Romultra/Think-Water/Report/IP First claims.pdf

## Claims :

1. Designing a hydration tracking system based on personalized information from the user
a. Use of sex, weight, age to put in a regression model to create a highly personalized software to calculate the daily water consumption.
2. The device works using 2 separate physical units with distinct functionalities.
a. The first one acting as a measurement unit.
b. The second one, that acts as a central processing unit.
3. In addition to claim 2, The product will use a combination of 2 different complementary stimuli.
a. An audio stimuli will be emitted from the base station
b. A visual stimuli will be emitted from the measurement device.
4. Following claim 2.a, the measurement unit is attachable to a glass or any surface using an attachment mechanism (pneumatic, magnetic, or else). Allowing for a transportable measurement unit ensuring simplicity of use.
5. Additionally, from claim 2.b, the base station is computing all the information and goals for the user and will be in charge of displaying it using a user interface such as a screen. It also acts as a storage unit.
a. The station is also equipped with a dynamic and tunable interface for the user. It can display many information such as the water consumption over different periods of time, where the user is compared to its daily goal, additional information such as temperature, humidity, time and date
6. Following claim 5, remote access to the data stored in the base can be accessed either by healthcare professionals, either by family or relatives to check on the water consumption from the user or for personal use to access it when far away from home.
