Romultra/Think-Water/Report/logos/Table of stakeholders.pdf

Stakeholders | Interests/Needs
Eldery people | Maintain proper hydration to support health and prevent dehydration-related issues
Use simple and reliable technology that helps them monitor water intake effortlessly Clear visual or auditory reminders to drink water
Families | Take care of their elders by ensuring they are properly hydrated
| Remote monitoring of the hydration level of their relatives Affordable and durable device suitable for household use
Hospitals, doctors, nurses at home | Hospitalize people if needed
| Send nurses at home for seniors Hygienic, easy-to-clean, and reusable device
| Meaningful estimation of water intake
EMS | Take care of elderly people
| Prevent any issues, ensure patients maintain adequate hydration Simple device setup and maintenance by staff
Public health actors/ Prevention | Check on elderly people to maintain optimal hydration during heat wave
| Reduce healthcare costs associated with dehydration-related illnesses, especially among elderly populations Promote public health and wellness through better hydration habits
Health care insurance | Reduce medical costs linked to dehydration-related hospitalizations
| Encourage preventive health behaviors among insured individuals
Investors | Association with an innovative and socially impactful product
| Participation in the growing health-tech market
| Return on investment through scalable market adoption
Suppliers | Demand for components or materials used in the device
| Long-term business relationships
Retailers | Expand their product offer with an innovative health technology
| After-sales support and warranty information
EPFL | Provide students with a practical and innovative project to develop skills in Product Design
| Promote research, experimentation, and real-world applications of course material
| Clear project goals, milestones, and deliverables from students
