Romultra/Think-Water/Report/Interview.pdf

Gaëtan Meystre, médecin à l'hôpital cantonal de Rennaz:
1. Êtes-vous renseigné sur les dangers et les conséquences de la déshydratation?
Oui : la déshydratation est notamment responsable de troubles électrolytiques (hypernatrémie) qui peuvent provoquer des troubles de l'état de conscience (confusion, coma, voire mort). L'hypovolémie due à la déshydratation peut également provoquer des affection rénales (insuffisance rénale aiguë) ou des troubles hémodynamiques et cardiaques (hypotension orthostatique, arythmies)
2. Quels sont les causes de déshydratation les plus communes ? (perception de la soif, mobilité réduite, perte d’autonomie, condition climatiques)
Effectivement avec l'âge la perception de la soif est altérée, étant probablement la cause la plus commune. Les troubles neurocognitifs peuvent également augmenter le risque (oubli de boire). La canicule est un exacerbateur au vu des pertes d'eau augmentées dues à la chaleur.
3. Y a-t-il des conditions médicales et des traitements qui améliorent ou empirent la déshydratation ?
Comme condition médicale qui me vient en tête je dirais le diabète (mellitus et insipide) qui part définition est une augmentation des pertes d'eau. Dans les traitements souvent prescrits, il y a les diurétiques utilisés dans le traitement de l'insuffisance cardiaque (chronique et aiguë) dont le but est d'augmenter la production d'urines pour éliminer l'eau accumulée.
4. Qui sont les personnes les plus concernées par la déshydratation?
Les personnes âgées.
5. Quels sont les coûts liés à la déshydratation pour une personne?
Aucune idée
6. Dans quelles mesures êtes-vous exposé aux problèmes de déshydratation? Je suis médecin dans un service de médecine interne, donc beaucoup...
7. Avez-vous une idée du taux d’hospitalisation dû à la déshydratation ?
Il y a pas beaucoup de patient dont le motif d'hospitalisation principal est la déshydratation. La plupart du temps ces patients viennent dans un contexte d'état confusionnel aigu, donc je dirais 2 % des patients hospitalisés ? Par contre beaucoup des patients qui sont hospitalisés pour un autre motif sont déshydratés.
8. Dans quelle mesure voyez vous la déshydratation comme un problème important de santé publique?
C'est un problème important qui touche une grande partie de la population âgée
9. Quelles solutions utilisez-vous déjà pour ce problème et y a t il des points d’amélioration ? J'utilise surtout la prévention, mais je doute qu'il y ait vraiment un impact. Parfois les patients ont des infirmiers à domiciles qui permettent un meilleur contrôle sur ce genre de problèmes, mais on ne les sollicite jamais que dans cet objectif là.
10. Avez vous des idées de solutions pour pallier au problème de la déshydratation ?
Des alarmes qui rappellent quand boire ?

Agnès Tissot :

1. Avez-vous déjà été exposé aux problèmes de déshydratation?

Oui surtout en lien avec deglutition prefere ne pas s’hdrater que de s'étouffer .

2. Quels sont les causes de déshydratation les plus communes ? (perception de la soif, mobilité réduite, perte d’autonomie, condition climatiques)

demence oublie sensation de soif peur de se lever 36000 fois prefere ne pas boire que de setrangler, fatigue

3. Y a-t-il des conditions médicales et des traitements qui améliorent ou empirent la déshydratation ?

deglutination ( épaississenment ou verres adaptés ) diminuer pb de deglute incontinence protection urinaire pour pas courir aux toilettes ou mettre en place une chaise percee

4. Qui sont les personnes les plus concernées par la déshydratation?

personnes agées clairement

5. Quels sont les coûts liés à la déshydratation pour une personne?

aucune idée

7. Avez-vous une idée du taux d’hospitalisation dû à la déshydratation ?

assez important

8. Dans quelle mesure voyez vous la déshydratation comme un problème important de santé publique?

très important consequences graves pour personnes agées

9. Quelles solutions utilisez-vous déjà pour ce problème et y a t il des points d’amélioration ?

dans mes patients oui , ce qui ont un suivi , moins de sequelles ( ex: desorientation liée a la deshydratation)

10. Avez vous des idées de solutions pour pallier au problème de la déshydratation ? des pistes de recherche qu’on pourrait creuser ?

système de memo , jouer sur les habitudes des gens pour que ca devienne une habitude solution facile daccées jouer sur les systemes cognitifs
