Romultra/Think-Water/Report/Capture d’écran 2025-11-23 à 21.23.33.png

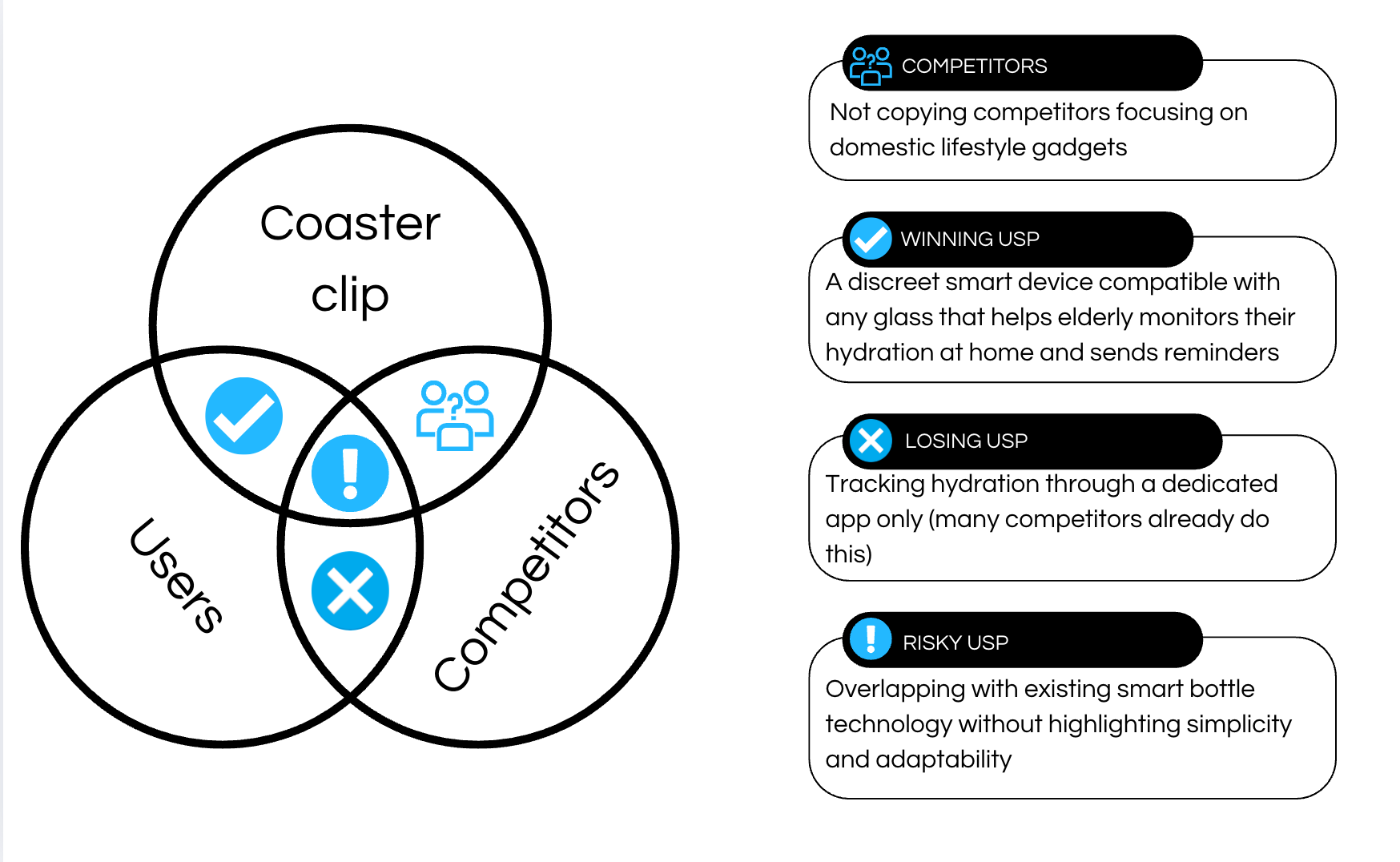
Report/Capture d’écran 2025-11-23 à 21.23.33.png
