Romultra/Think-Water/Report/CONOPS.png

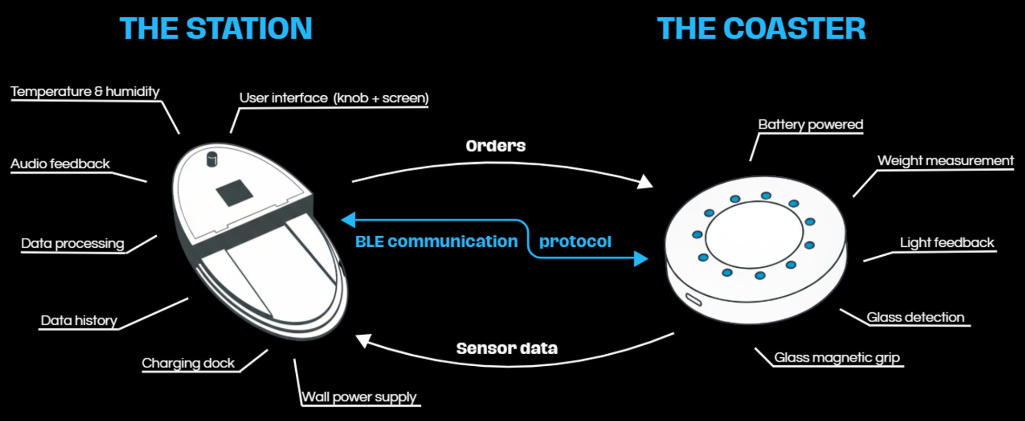
Report/CONOPS.png
