Romultra/Think-Water/Report/Photos/base_station.png

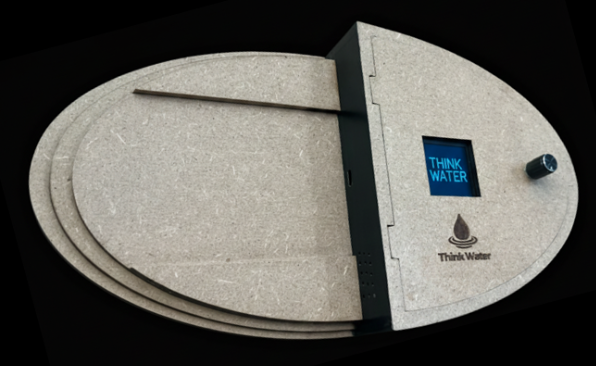
Report/Photos/base_station.png
