Romultra/Think-Water/Report/Photos/coaster.png

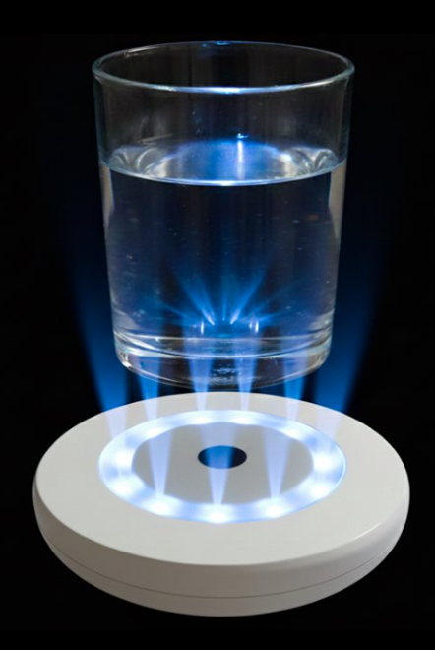
Report/Photos/coaster.png
