Romultra/Think-Water/Report/Photos/ConOps.png

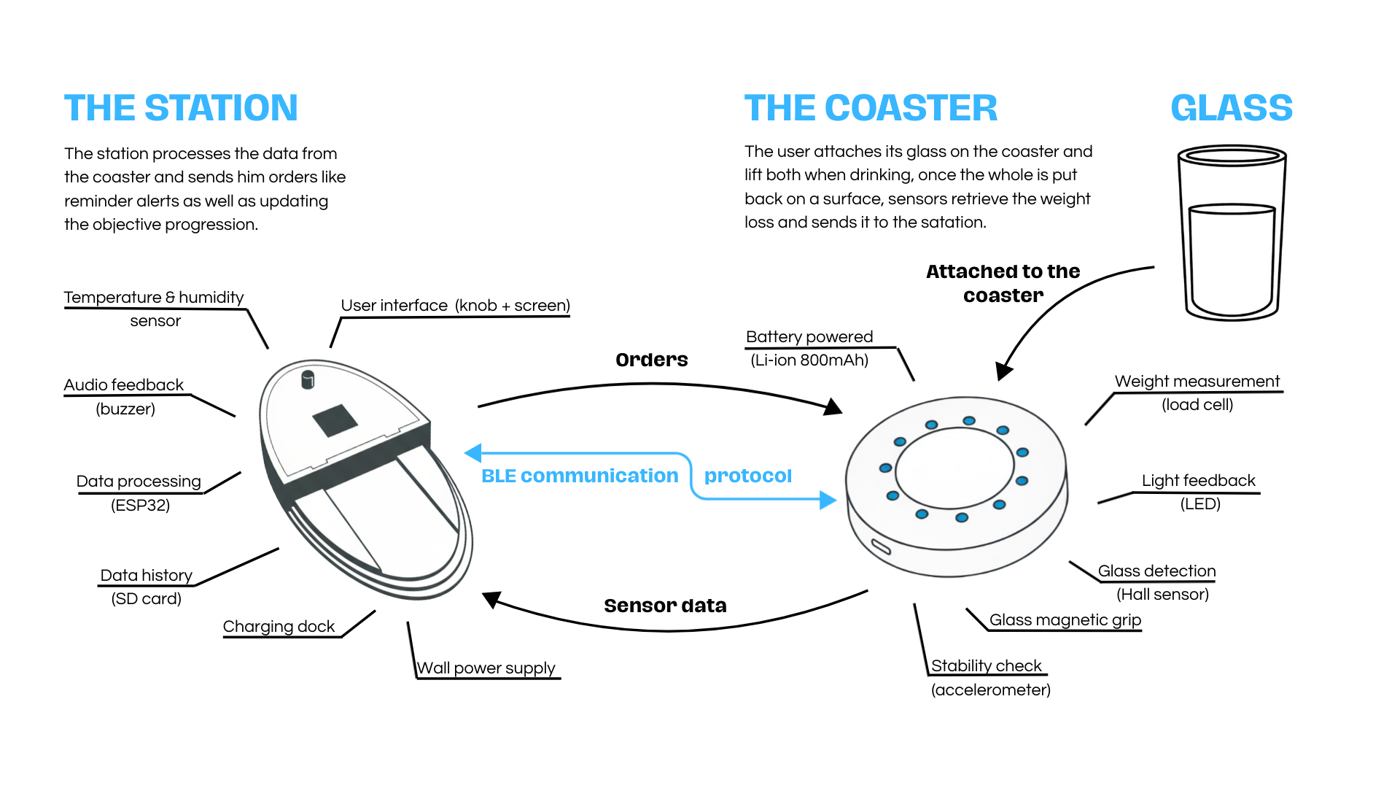
Report/Photos/ConOps.png
