Romultra/Think-Water/Report/Photos/prix.png

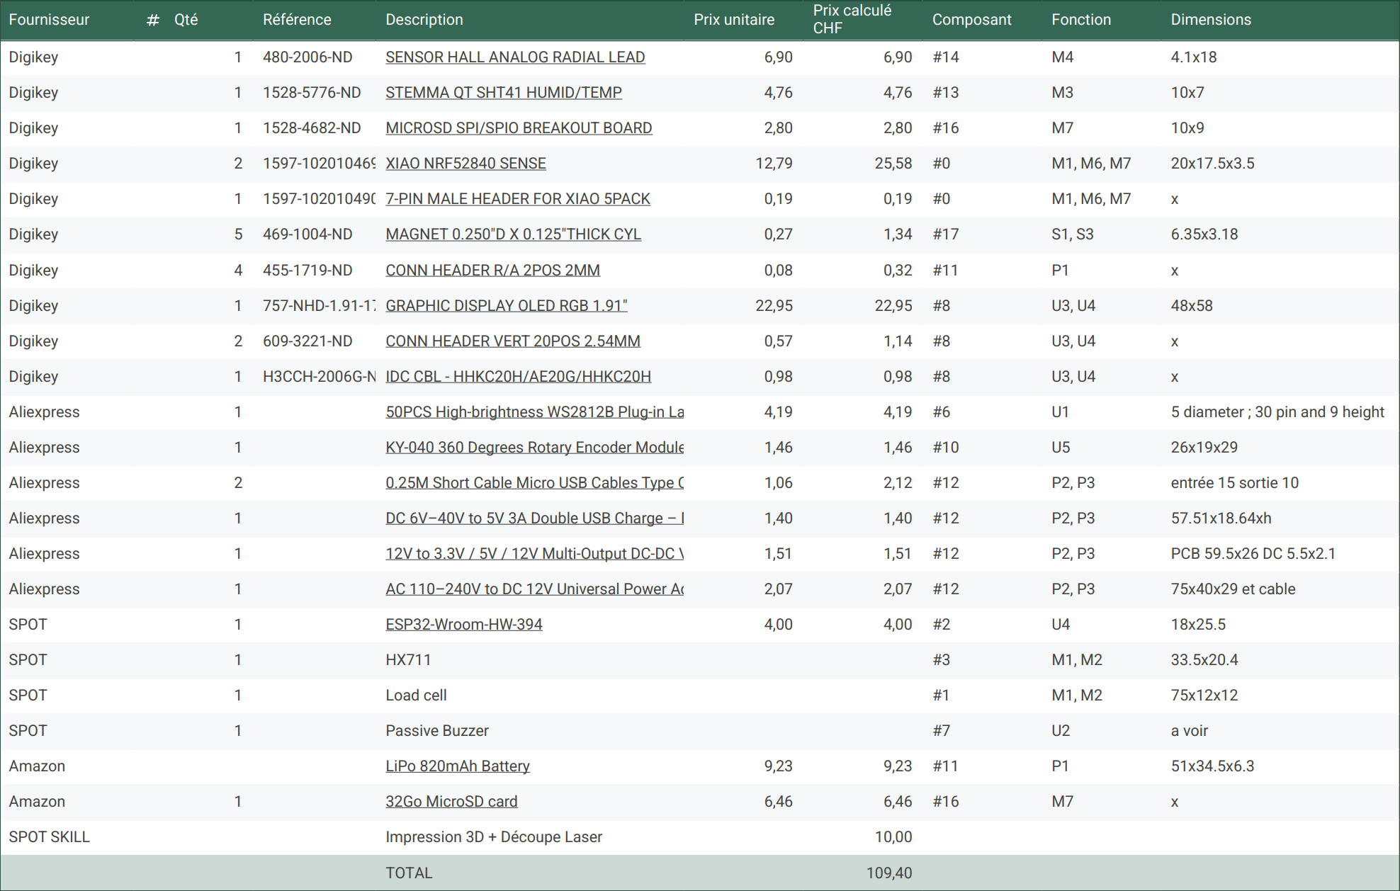
Report/Photos/prix.png
