Romultra/Think-Water/Report/Photos/support_battery.png

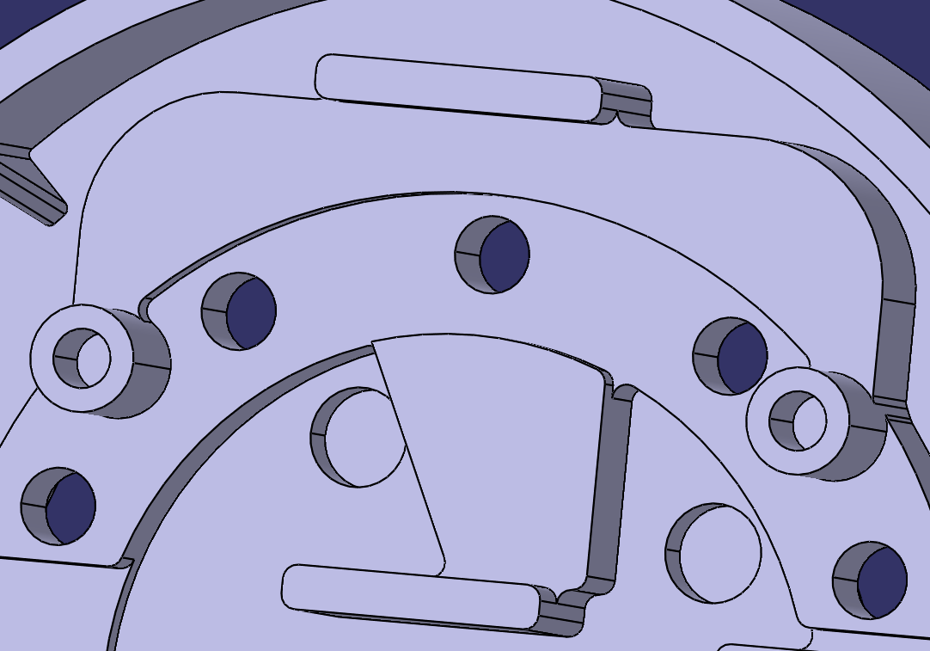
Report/Photos/support_battery.png
