Romultra/Think-Water/Report/Photos/support_loadcell.png

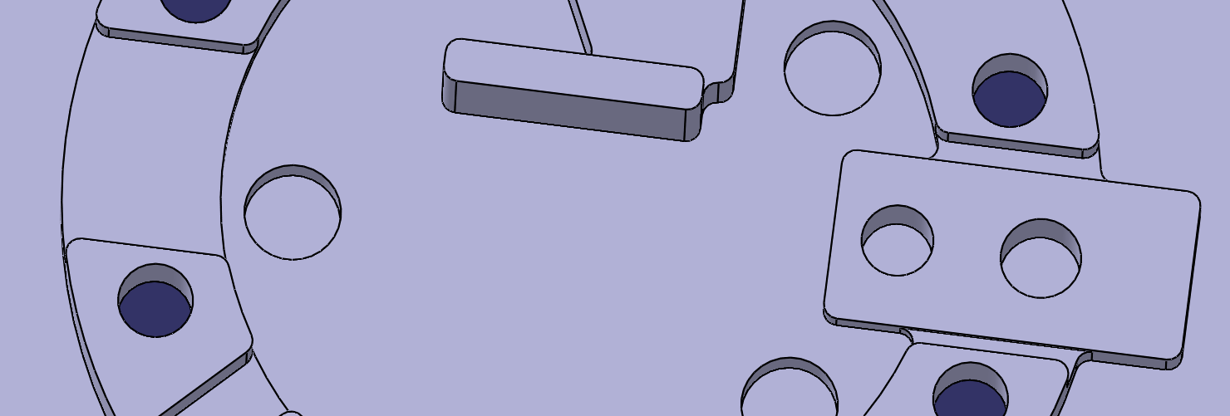
Report/Photos/support_loadcell.png
