Romultra/Think-Water/Report/Photos/support_micro.png

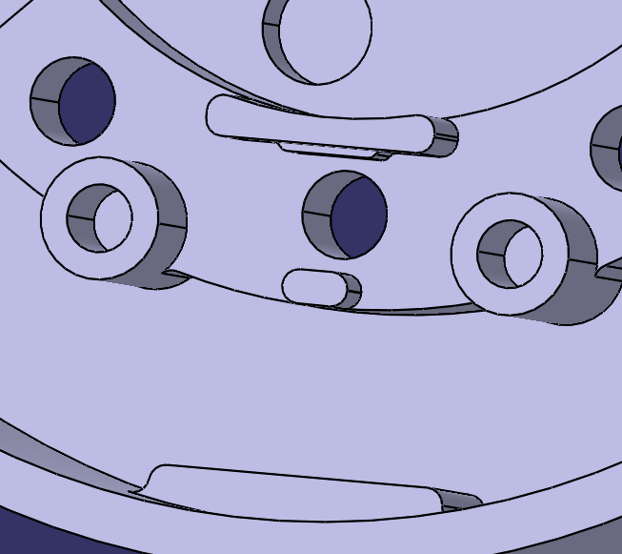
Report/Photos/support_micro.png
