Romultra/Think-Water/Calibration/CALIB.CSV

reference_g | raw_value
0.00 | -57550
100.00 | -94875
50.00 | -76181
20.00 | -64986
10.00 | -61236
0.00 | -57490
5.00 | -59278
4.00 | -58951
2.00 | -58188
1.00 | -57782
0.00 | -57409
150.00 | -113445
170.00 | -120916
200.00 | -132121
80.00 | -87260
70.00 | -83500
170.00 | -120867
160.00 | -117166
210.00 | -135856
100.00 | -94651
0.50 | -57477
0.00 | -57298
