Romultra/Think-Water/Calibration/HALL.CSV

state | min | max | avg
with_glass | 453 | 457 | 454
with_glass | 448 | 459 | 454
no_glass | 471 | 477 | 473
no_glass | 471 | 477 | 473
with_glass | 453 | 458 | 455
with_glass | 447 | 458 | 454
no_glass | 465 | 476 | 473
no_glass | 464 | 478 | 473
with_glass | 453 | 459 | 455
no_glass | 464 | 476 | 473
with_glass | 453 | 459 | 454
with_glass | 454 | 459 | 456
with_glass | 453 | 457 | 454
no_glass | 467 | 476 | 473
