Romultra/Think-Water/Calibration/calibration_plot.png

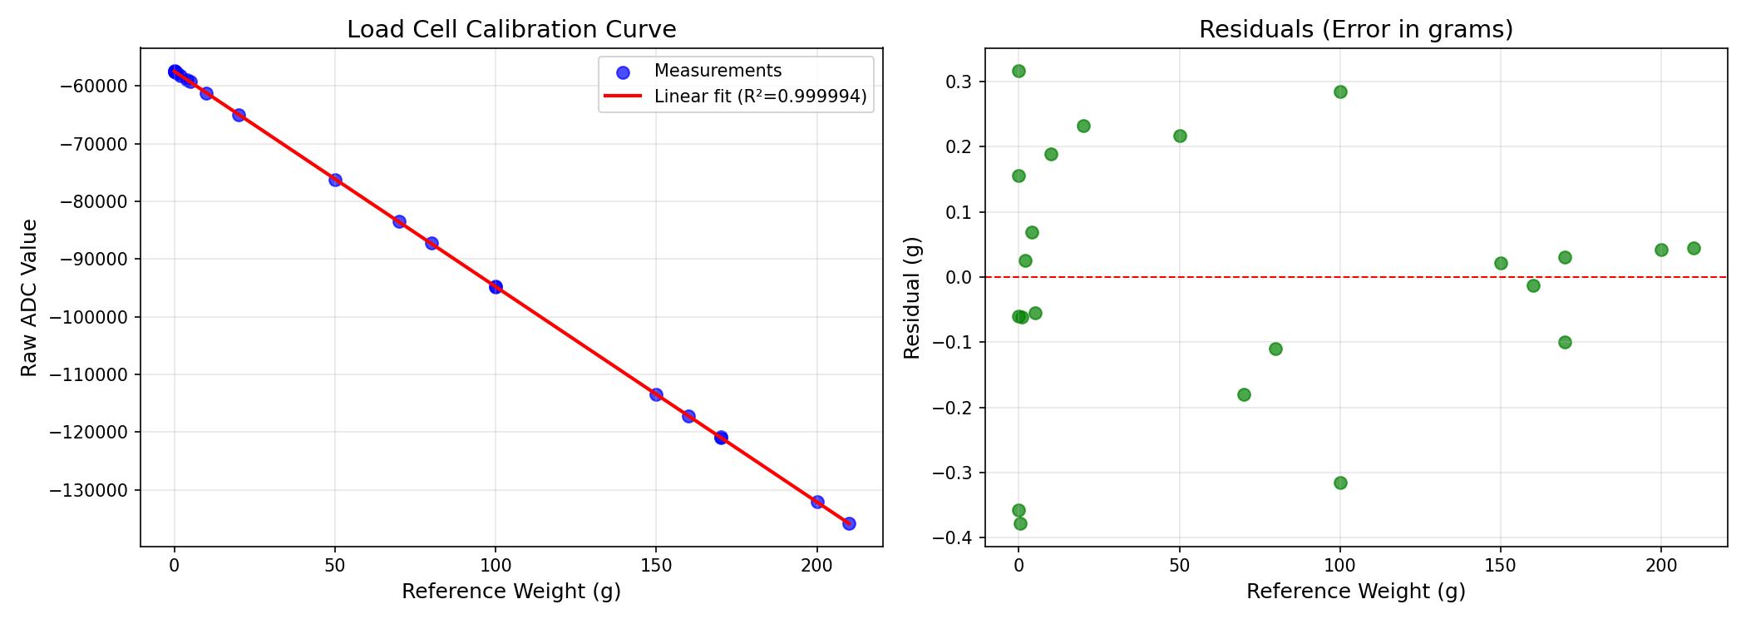
Calibration/calibration_plot.png
