Romultra/Think-Water/Schematics/Base-Station.pdf

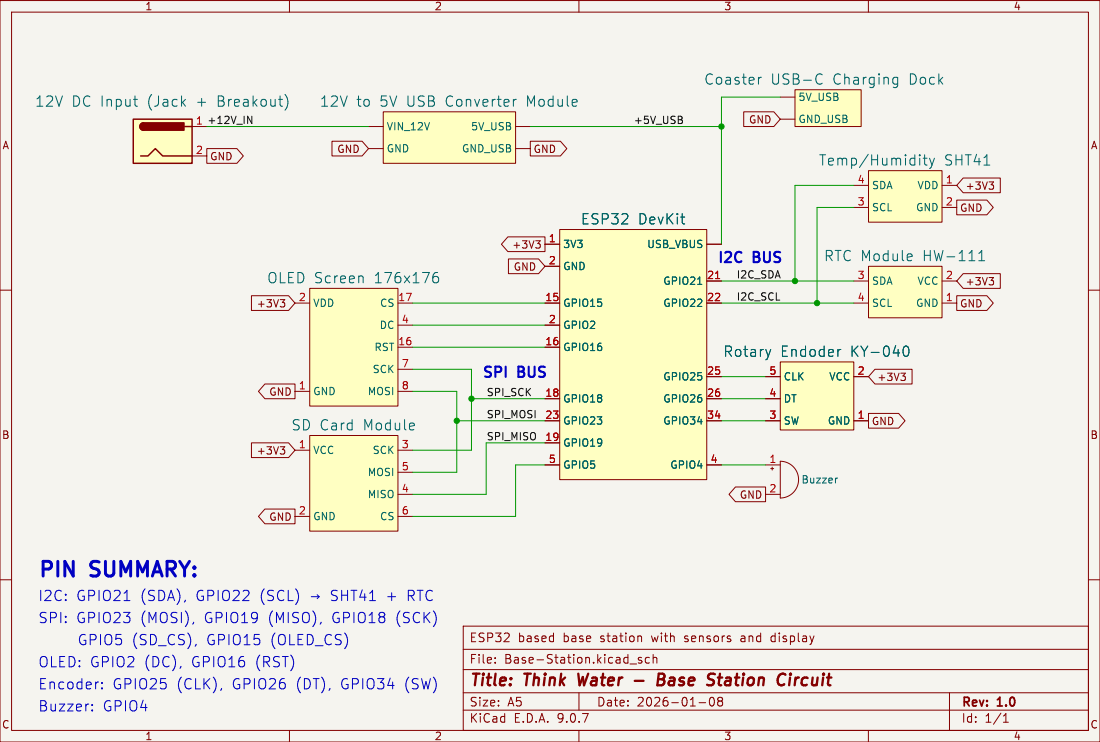
[picture p29: page 1]

PIN SUMMARY:
I2C: GPIO21 (SDA), GPIO22 (SCL) þÿ!’SHT41 + RTC
SPI: GPIO23 (MOSI), GPIO19 (MISO), GPIO18 (SCK)
GPIO5 (SD_CS), GPIO15 (OLED_CS)
OLED: GPIO2 (DC), GPIO16 (RST)
Encoder: GPIO25 (CLK), GPIO26 (DT), GPIO34 (SW)
