Romultra/Think-Water/Schematics/Coaster.pdf

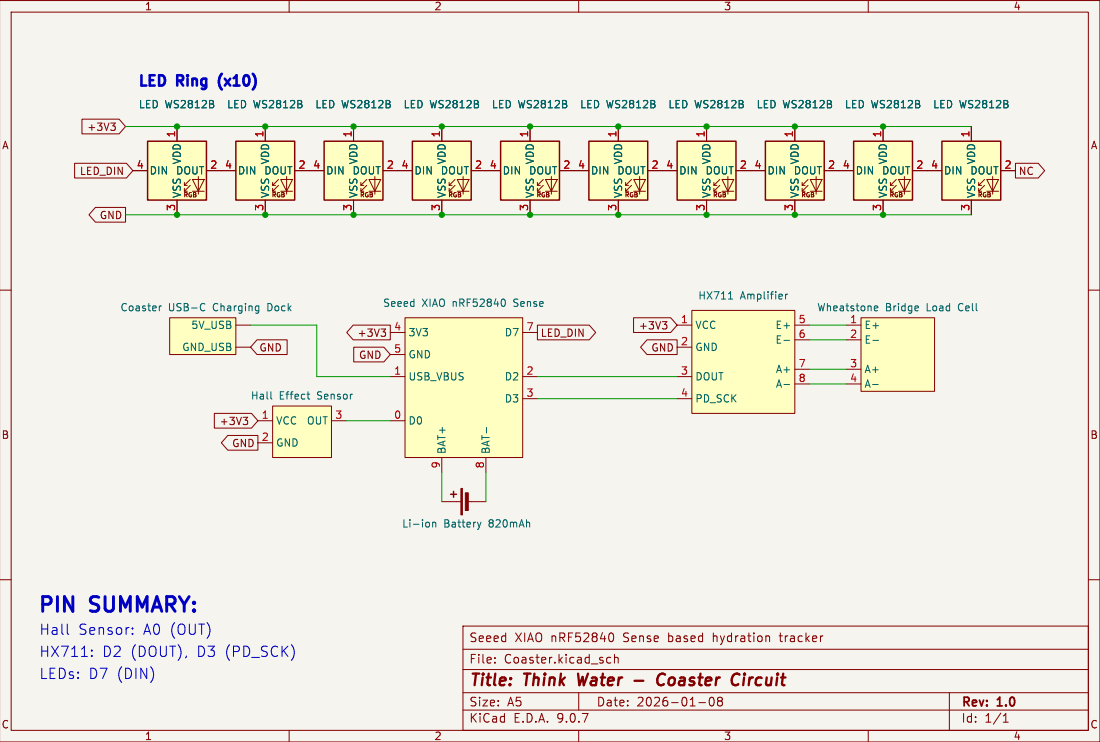
[picture p30: page 1]

9 BAT- 8 D7 7 D2 2 D3 3 Seeed XIAO nRF52840 Sense

5V_USB GND_USB Coaster USB-C Charging Dock
