Romultra/Think-Water/Schematics/Base-Station/Base-Station.kicad_sch

## KiCad design Schematics/Base-Station/Base-Station.kicad_sch (2026-05-09)

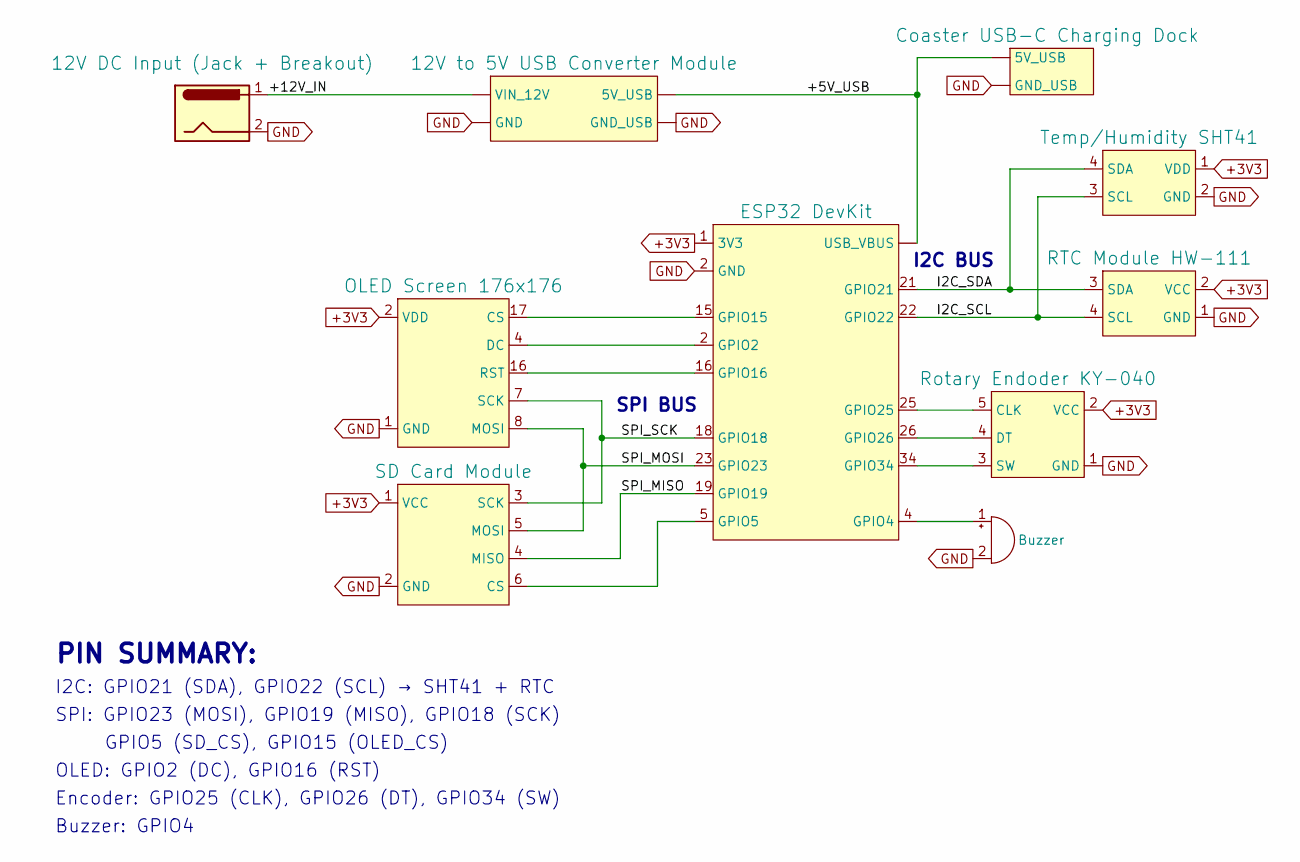
[picture p31: schematic Base-Station.kicad_sch]

Parts:
B1: Buzzer
J1: 12V DC Input (Jack + Breakout)
U1: Rotary Endoder KY-040
U2: ESP32 DevKit
U3: Temp/Humidity SHT41
U4: RTC Module HW-111
U5: SD Card Module
U6: OLED Screen 176x176
U7: Coaster USB-C Charging Dock
U8: 12V to 5V USB Converter Module

Connections:
+3V3: U1.2 (VCC), U2.1 (3V3), U3.1 (VDD), U4.2 (VCC), U5.1 (VCC), U6.2 (VDD)
+5V_USB: U2. (USB_VBUS), U7., U8.
+12V_IN: J1.1, U8.
GND: B1.2 (-), J1.2, U1.1 (GND), U2.2 (GND), U3.2 (GND), U4.1 (GND), U5.2 (GND), U6.1 (GND), U7., U8.
I2C_SCL: U2.22 (GPIO22), U3.3 (SCL), U4.4 (SCL)
I2C_SDA: U2.21 (GPIO21), U3.4 (SDA), U4.3 (SDA)
unnamed: B1.1 (+), U2.4 (GPIO4)
unnamed: U1.3 (SW), U2.34 (GPIO34)
unnamed: U1.4 (DT), U2.26 (GPIO26)
unnamed: U1.5 (CLK), U2.25 (GPIO25)
unnamed: U2.2 (GND), U6.4 (DC)
unnamed: U2.5 (GPIO5), U5.6 (CS)
unnamed: U2.15 (GPIO15), U6.17 (CS)
unnamed: U2.16 (GPIO16), U6.16 (RST)
SPI_MISO: U2.19 (GPIO19), U5.4 (MISO)
SPI_MOSI: U2.23 (GPIO23), U5.5 (MOSI), U6.8 (MOSI)
SPI_SCK: U2.18 (GPIO18), U5.3 (SCK), U6.7 (SCK)

Notes on the sheet:
GPIO5 (SD_CS), GPIO15 (OLED_CS)
Encoder: GPIO25 (CLK), GPIO26 (DT), GPIO34 (SW)
Buzzer: GPIO4
PIN SUMMARY:
SPI: GPIO23 (MOSI), GPIO19 (MISO), GPIO18 (SCK)
I2C BUS
SPI BUS
I2C: GPIO21 (SDA), GPIO22 (SCL) → SHT41 + RTC
OLED: GPIO2 (DC), GPIO16 (RST)
