Romultra/Think-Water/Schematics/Coaster/Coaster.kicad_sch

## KiCad design Schematics/Coaster/Coaster.kicad_sch (2026-05-09)

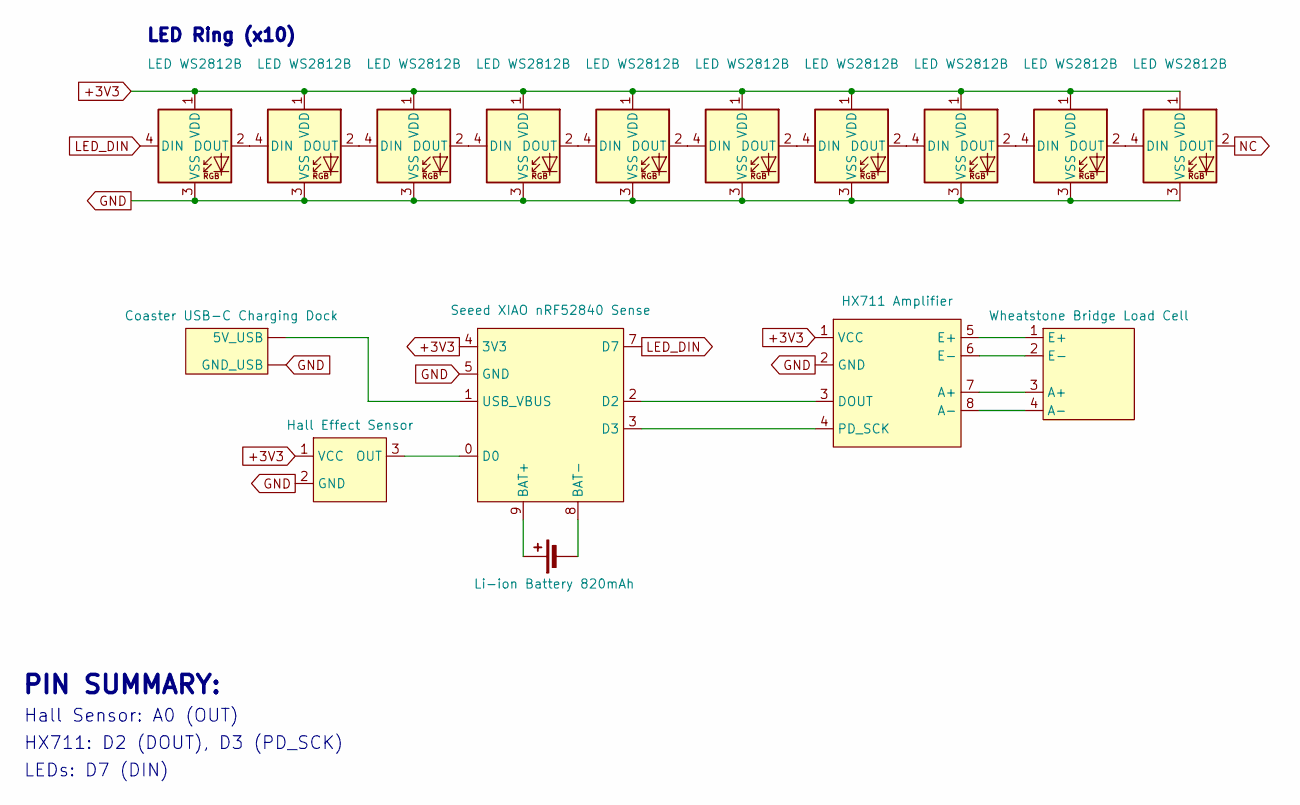
[picture p32: schematic Coaster.kicad_sch]

Parts:
BT1: Li-ion Battery 820mAh
D1, D2, D3, D4, D5, D6, D7, D8, D9, D10: LED WS2812B; LED_WS2812B_PLCC4_5.0x5.0mm_P3.2mm
LC1: Wheatstone Bridge Load Cell
U1: Hall Effect Sensor
U2: HX711 Amplifier
U3: Seeed XIAO nRF52840 Sense
U4: Coaster USB-C Charging Dock

Connections:
+3V3: D1.1 (VDD), D2.1 (VDD), D3.1 (VDD), D4.1 (VDD), D5.1 (VDD), D6.1 (VDD), D7.1 (VDD), D8.1 (VDD), D9.1 (VDD), D10.1 (VDD), U1.1 (VCC), U2.1 (VCC), U3.4 (3V3)
GND: D1.3 (VSS), D2.3 (VSS), D3.3 (VSS), D4.3 (VSS), D5.3 (VSS), D6.3 (VSS), D7.3 (VSS), D8.3 (VSS), D9.3 (VSS), D10.3 (VSS), U1.2 (GND), U2.2 (GND), U3.5 (GND), U4.
LED_DIN: D1.4 (DIN), U3.7 (D7)
NC: D10.2 (DOUT)
unnamed: BT1.1 (+), U3.9 (BAT+)
unnamed: BT1.2 (-), U3.8 (BAT-)
unnamed: D1.2 (DOUT), D2.4 (DIN)
unnamed: D2.2 (DOUT), D3.4 (DIN)
unnamed: D3.2 (DOUT), D4.4 (DIN)
unnamed: D4.2 (DOUT), D5.4 (DIN)
unnamed: D5.2 (DOUT), D6.4 (DIN)
unnamed: D6.2 (DOUT), D7.4 (DIN)
unnamed: D7.2 (DOUT), D8.4 (DIN)
unnamed: D8.2 (DOUT), D9.4 (DIN)
unnamed: D9.2 (DOUT), D10.4 (DIN)
unnamed: LC1.1 (E+), U2.5 (E+)
unnamed: LC1.2 (E-), U2.6 (E-)
unnamed: LC1.3 (A+), U2.7 (A+)
unnamed: LC1.4 (A-), U2.8 (A-)
unnamed: U1.3 (OUT), U3.0 (D0)
unnamed: U2.3 (DOUT), U3.2 (D2)
unnamed: U2.4 (PD_SCK), U3.3 (D3)
unnamed: U3.1 (USB_VBUS), U4.

Notes on the sheet:
HX711: D2 (DOUT), D3 (PD_SCK)
LEDs: D7 (DIN)
LED Ring (x10)
PIN SUMMARY:
Hall Sensor: A0 (OUT)
