Romultra/Think-Water/(commit log)

2025-12-08 Add initial event-driven FSM structure, accelerometer and hall sensor logic
2025-12-10 Implement drink detection, LED feedback, and dynamic polling
    Major refactor of the main event loop and state machine to support drink consumption tracking and user feedback.
    Key changes:
    - **Drink Detection**: Implemented logic to calculate weight difference (`prevWeight` vs current) to detect drinks > 5g and update `totalConsumed`.
    - **State Machine**:
    - Introduced dynamic heartbeat polling: switches to `FAST_POLL_MS` (200ms) during motion and `SLOW_POLL_MS` (2s) when idle.
    - Removed `ALERTING` state and `DRINK_DETECTED` event; added `CHECK_FOR_DRINK` event.
    - Centralized glass presence checks and BLE command handling at the start of the event loop.
    - **Tasks**: Added `ledAlertTask`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
2025-12-14 Add SSD1333 OLED driver implementation and header files
2025-12-14 Refactor load cell stability detection and remove IMU dependencies
2025-12-14 Refactor state machine and fix concurrency issues
    - Add LED mutex to prevent concurrent animation conflicts between
    ledAlertTask and ledFeedbackTask
    - Replace MOTION_DETECTED events with loadcell-based stability detection
    for IDLE↔MOVING state transitions
    - Remove unused shouldAdvertise variable and WAKEUP event type
    - Initialize prevWeight to NAN to prevent false drink detection on startup
    - Use cached loadcellLastWeight instead of redundant getWeight() calls
    - Fix uninitialized Event struct fields before queue send
    - Clean up indentation and fix typos (heartbear→heartbeat, waik-up→wake-up)
    - Fix NEON_PIXEL_PIN typo to NEO_PIXEL_PIN
    - Add TODO.md to .gitignor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
2025-12-15 Fix SSD1333 OLED driver initialization sequence
    - Fix swapped NORMAL_DISPLAY/ALL_OFF command definitions (0xA4/0xA6)
    - Correct display offset, remap, clock divider, and phase length values
    - Add missing second pre-charge period and gamma LUT initialization
    - Remove invalid SET_MASTER_CFG command (0xAD)
    - Set remap to 0x66 for correct horizontal orientation
    [oled-ssd1333.cpp, oled-ssd1333.h]
2025-12-15 Implement ESP32 base station firmware with hydration tracking
    Base station features:
    - SHT41 temperature/humidity sensor with 24h rolling average
    - SD card logging for sensor readings and consumption events
    - BLE connect-on-demand: only connects when coaster has data or base needs to send
    - Daily hydration goal calculation using water turnover model (×0.65)
    - Trajectory monitoring with 15% behind threshold
    - Drinking reminders via buzzer and BLE LED alert
    - Time sync via serial (TIME:<unix_timestamp>)
    Coaster changes:
    - Add manufacturer data to BLE advertisement with data pending flag
    - Base station can now detect when coaster has consumption data to send
    [main-base.cpp, main-coaster.cpp, water-turnover.cpp]
2025-12-16 Implement full-featured base station UI with OLED and rotary encoder
    Add comprehensive user interface for the ESP32 base station featuring:
    - OLED display integration with SSD1333 driver (176x176 color screen)
    - KY-040 rotary encoder support with click functionality
    - Initial setup flow for user configuration (age, sex, weight, time)
    - Main display showing hydration progress, daily goal, temp, and humidity
    - Settings menu for modifying personal info and time
    - Debug menu for manual BLE commands (alert, goal update, day reset)
    - User configuration persistence on SD card
    - Continuous BLE scanning for instant coaster connections (<1s response)
    - Button-activated menu navigation (click for menu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
    [main-base-ui.cpp]
2025-12-17 Improve BLE state machine reliability and timing
    - Refactor BLE scanning to run continuously until connection needed
    - Fix memory leak by reusing BLE client and using static callbacks
    - Add proper characteristic cleanup on disconnect
    - Improve scan parameters for faster device discovery (62.5ms interval)
    - Add buzzer timing constants for alert feedback
    - Move buzzer sound to after successful alert delivery
    - Enhance connection error handling and logging
    - Remove unused scan stop function and redundant test display code
    [main-base-ui.cpp]
2025-12-17 Fix hall sensor logic and HX711 stability issues
    - Reverse hall sensor logic: now correctly returns true when glass present
    - Add timeout waiting for HX711 to be ready between reads
    - Fix intermittent "Load cell not ready" errors caused by HX711 conversion timing
    - Reduce get_units samples from 10 to 2 for faster reads
    - Update hall sensor thresholds and NeoPixel pin configuration
    - Add debug prints for stability check diagnostics
    [main-coaster.cpp]
2025-12-17 Add calibration firmware for load cell and hall sensor
    - Add coaster-calibration environment for nRF52840 BLE peripheral
    - Add base-calibration environment for ESP32 calibration controller
    - Coaster exposes BLE commands for load cell and hall sensor measurements
    - Base controller sends commands and logs calibration data to SD card
2025-12-17 Improve OLED UI reliability and polish
    - Add robust SD card initialization with retry logic and 500ms delay
    to fix configuration persistence on cold boot
    - Fix humidity % symbol spacing using dynamic positioning
    - Center setup screen values between label and unit text
    - Change default sex configuration from male to female
    - Improve overall UI spacing and readability
    [main-base-ui.cpp]
2025-12-17 Enhance LED feedback animation with reversed rotation and fade-out
    - Remap LED positions to start at 7th LED (index 6) and rotate in reverse
    - Add smooth 600ms fade-out effect after 2s display hold
    - Add 'F' serial command to trigger feedback animation in TEST mode
    - Remove verbose debug output from loadcell stability checks
    [main-coaster.cpp]
2025-12-17 Update documentation for LED feedback enhancements and TEST mode
    - Document LED feedback animation details (mapping, timing, fade-out)
    - Add TEST mode serial commands table
2025-12-17 Calibrate load cell and hall sensor from measurements
    Load cell calibration:
    - Scale: -373.3692 raw units/gram
    - Offset: -57432 raw units at 0g
    - Use raw readings for deviation check (more precision)
    - Raw deviation threshold: 100 units
    Hall sensor calibration:
    - Threshold high (no glass): 464
    - Threshold low (glass present): 460
    Also includes calibration data files and Python analysis script.
    [CALIB.CSV, HALL.CSV]
2025-12-17 Optimize loadcell stability check with two-phase approach
    Split stability detection into fast magnitude check and slow deviation check.
    During MOVING states, fast period (200ms) only does quick magnitude reading.
    When coaster lands on table, switches to slow period (2000ms) for full
    deviation sampling. Prevents heartbeat event pileup and ensures proper
    transitions back to IDLE states.
    [main-coaster.cpp]
2025-12-18 Fix progress update logic
    [main-base-ui.cpp]
2025-12-19 Replace SD card with NVS flash storage and add boot logo
    Replace SD card functionality with ESP32's built-in NVS (Non-Volatile Storage) to reduce hardware complexity and improve reliability. User configuration and daily consumption totals are now stored in flash memory using the Preferences library, eliminating the need for an SD card module.
    - Store user config (age, sex, weight) and consumption data in NVS flash
    - Add compressed boot logo displayed from flash (16.8 KB, 72% space savings)
    - Use current sensor readings for stable daily hydration goal calculation
    - Restore default SPI configuration for OLED-only operation
    - Remove SD card libraries and reduce flash usage by 43 K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
    [main-base-ui.cpp]
2025-12-19 Fix state machine bugs and add timing documentation
    Critical fixes:
    - Fix wasPickedUp flag never cleared after drink detection
    - Fix wasPickedUp flag handling in MOVING→IDLE transitions
    - Remove unused fastPeriodActive variable
    - Remove unused CHECK_FOR_DRINK event
    State machine improvements:
    - Add SETTLING states for proper loadcell timing
    - Implement two-phase stability checking (magnitude + deviation)
    - Add adaptive polling based on state (FAST 200ms in air, SLOW 700ms on table)
    - Enable direct MOVING→IDLE transition when water already stable
    Documentation:
    - Add comprehensive timing constraints documentation
    - Explain why SETTLING states are architecturally necessary
    - Document HX7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
    [main-coaster.cpp]
2025-12-19 Add total consumption sync between coaster and base station
    Implements bidirectional BLE synchronization to ensure both devices
    always display the same progress percentage. Base station (with NVS
    persistence) is the source of truth and syncs the total back to the
    coaster after each consumption event.
    Changes:
    - Add TOTAL_SYNC_CHAR_UUID BLE characteristic for total sync
    - Coaster receives synced total from base instead of tracking locally
    - Base station sends updated total after consumption events, day changes,
    goal updates, and on startup
    - Prevents desynchronization between devices
    [main-base-ui.cpp, main-coaster.cpp]
2025-12-19 Refactor to progress percentage sync instead of goal + total
    Simplifies BLE protocol by sending only progress percentage (0.0-1.0)
    instead of separate goal and total values. Base station calculates
    progress and coaster displays it directly without any math.
    - Remove GOAL_CHAR_UUID and TOTAL_SYNC_CHAR_UUID characteristics
    - Add single PROGRESS_CHAR_UUID for progress percentage
    - Coaster receives progress directly, no division needed
    - Base station calculates progress = totalConsumed / dailyGoal
    - Reduces BLE traffic from 8 bytes to 4 bytes per sync
    - Simplifies coaster logic (pure display peripheral)
    - Net code reduction: 107 deletions, 74 insertions (-33 lines)
    Benefits: Simpler p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
2025-12-19 Add demo debug options and scrolling to debug menu
    Debug menu enhancements:
    - Add 'Set 40%' and 'Set 100%' options to fast-forward hydration progress for demos
    - Add 'Erase Config' option to reset device to initial setup state
    - Rename 'Send Goal' to 'Sync Progress' to reflect progress percentage sync
    - Implement scrolling with visual indicators (up/down arrows) for 7 menu options
    - Display shows 4 options at a time with automatic scroll to keep selection visible
    [main-base-ui.cpp]
2026-01-07 Update power consumption model and enhance battery autonomy calculations
2026-01-08 Clarify attachment mechanism description by specifying the use of 3M VHB RP45 tape
2026-05-09 Add KiCad schematics for coaster and base station, update report with schematics and logos
    [Base-Station.kicad_sch, Coaster.kicad_sch]
